felippekalil/MultiAVC/Documentação/Diagrama AVC ComarcIII.jpg

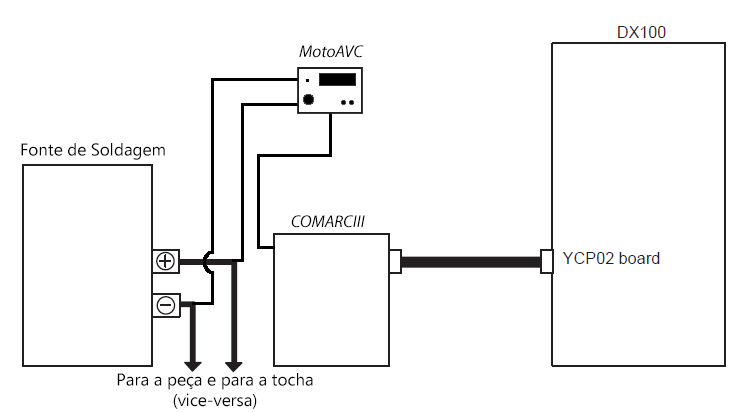
Documentação/Diagrama AVC ComarcIII.jpg
