felippekalil/MultiAVC/Documentação/Esquemático/LCD tela/TelaInicial.jpg

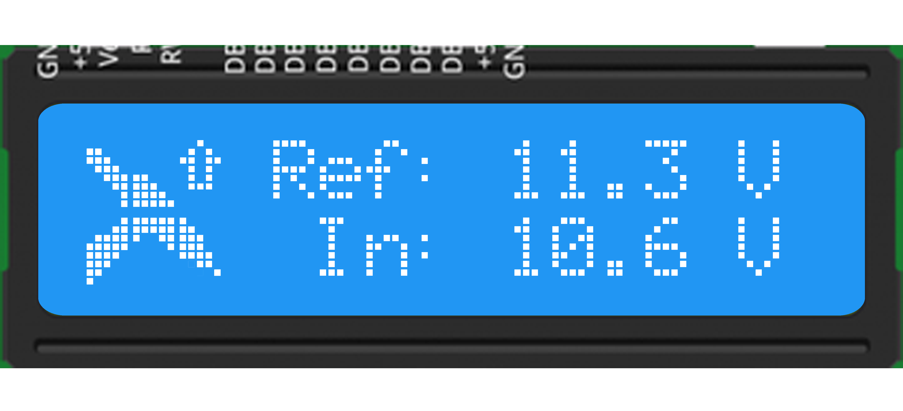
Documentação/Esquemático/LCD tela/TelaInicial.jpg
