felippekalil/MultiAVC/Documentação/IHM Exec.jpg

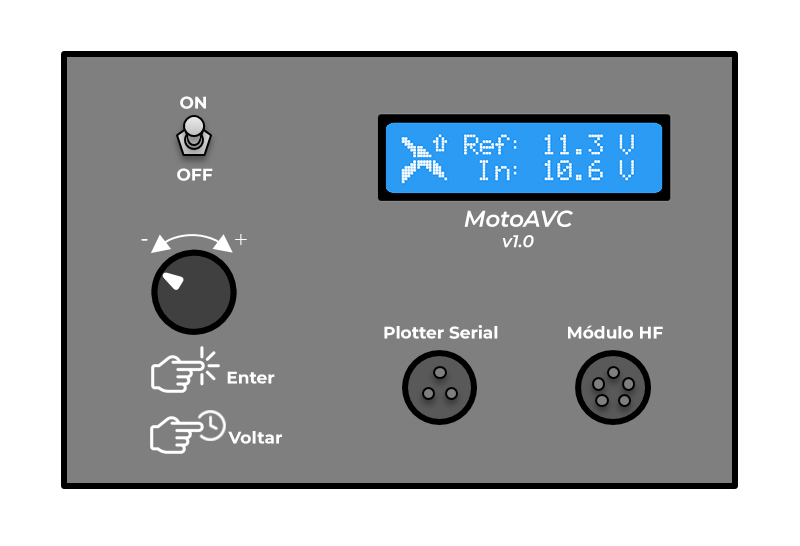
Documentação/IHM Exec.jpg
