felippekalil/MultiAVC/Documentação/Placa Filtro HF/Circuito Filtro HF.jpeg

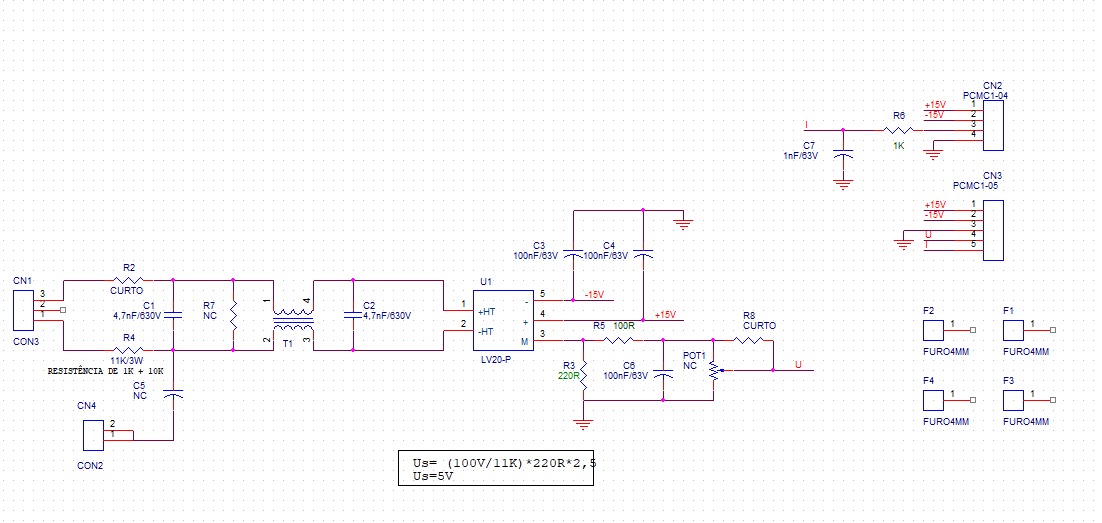
Documentação/Placa Filtro HF/Circuito Filtro HF.jpeg
