felippekalil/MultiAVC/PlotterAVC/Resources/simbolo_labsolda.png

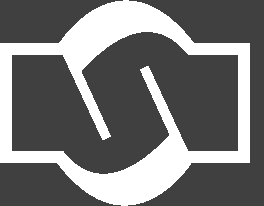
PlotterAVC/Resources/simbolo_labsolda.png
