felippekalil/MultiAVC/MotoAVC/Calibração Entrada.xlsx

ENTRADA PLACA | Tensão Display | Entrada ISO | ln | LNeper | Tensão Display | LNeper
0.1 | 0.08 | 0.08 | -2.525728644 | 2.525728644 | 0.08 | 2.525728644 | -1.003671372 | 0.07850838051 | -0.00149161949 | -1.003671 | 0.0785084485 | -0.0014915515
1.19 | 1.15 | 1.17 | 0.1570037488 | -0.1570037488 | 1.25 | -0.2231435513 | 0.9904970717 | 1.239136077 | 0.06913607729 | 0.990497 | 1.239135885 | 0.06913588489
1.92 | 1.85 | 2.62 | 0.9631743178 | -0.9631743178 | 2.67 | -0.9820784724 | 0.9983872139 | 2.654179794 | 0.03417979385 | 0.9991955079 | 2.654178633 | 0.03417863336
2.55 | 2.49 | 3.85 | 1.348073148 | -1.348073148 | 3.82 | -1.340250423 |  | 3.802362601 | -0.04763739914 |  | 3.802360432 | -0.04763956764
3.58 | 3.48 | 4.38 | 1.477048724 | -1.477048724 | 4.23 | -1.442201993 |  | 4.212045864 | -0.1679541359 |  | 4.212043302 | -0.1679566975
4.37 | 4.13 | 4.74 | 1.556037136 | -1.556037136 | 4.38 | -1.477048724 |  | 4.361967207 | -0.3780327935 |  | 4.361964497 | -0.3780355028
4.78 | 4.35 | 5 | 1.609437912 | -1.609437912 | 4.38 | -1.477048724 |  | 4.361967207 | -0.6380327935 |  | 4.361964497 | -0.6380355028
5 | 4.38
