felippekalil/MultiAVC/Documentação/Esquemático/MotoAVC Proteus/MotoAVC.PDF

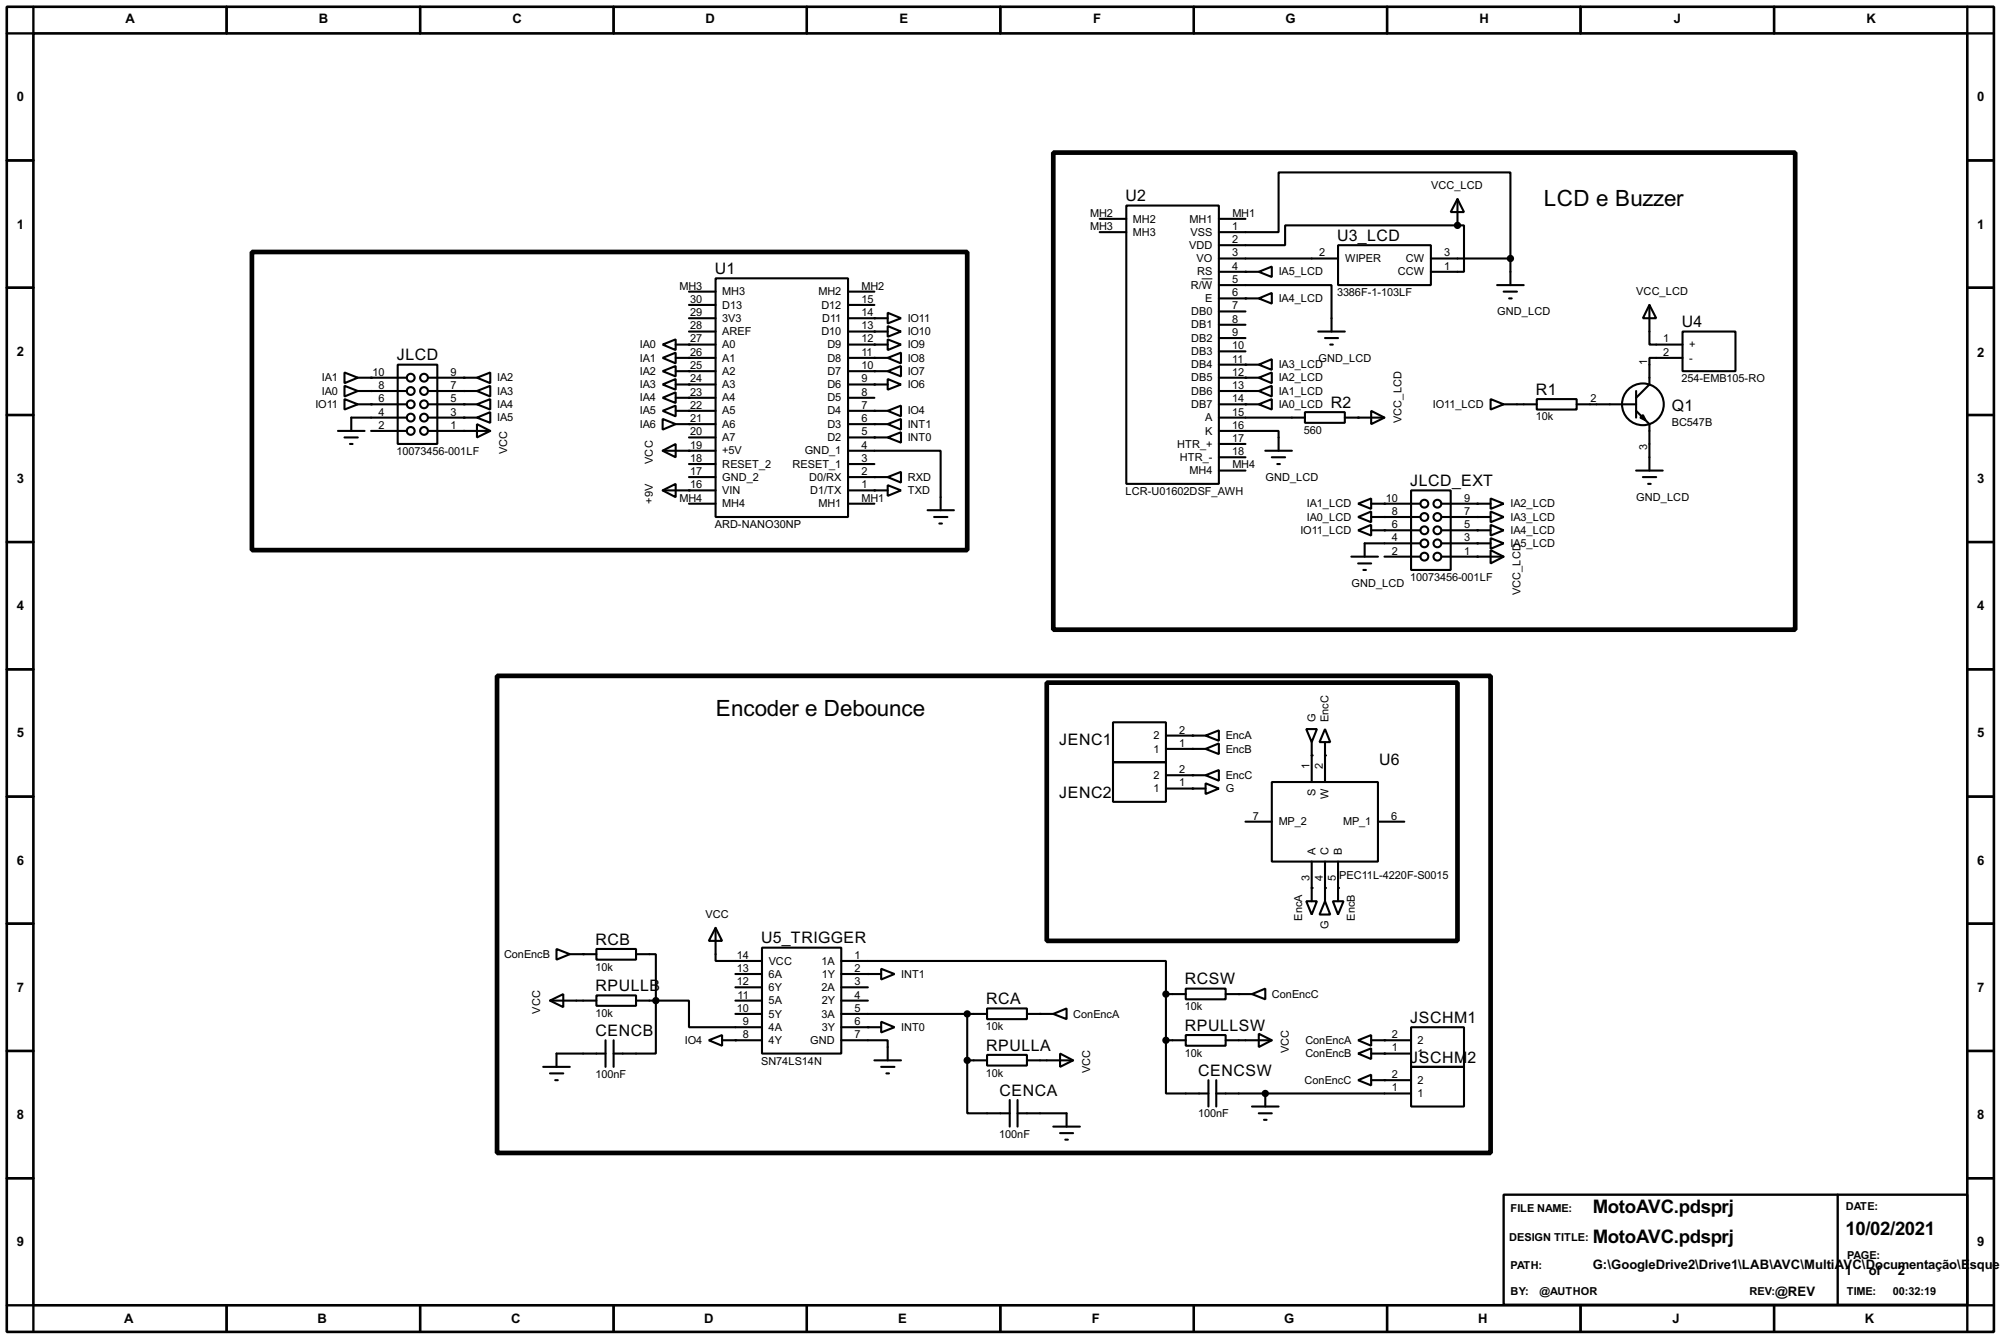
[picture p14: page 1]

2 VO
3 RS 4 R/W IA5_LCD 5 E | CCW | 1 WIPER

6 DB0 | IA4_LCD

10 | 10k
9 | 6 GND 7

FILE NAME:
DESIGN TITLE: MotoAVC.pdsprj

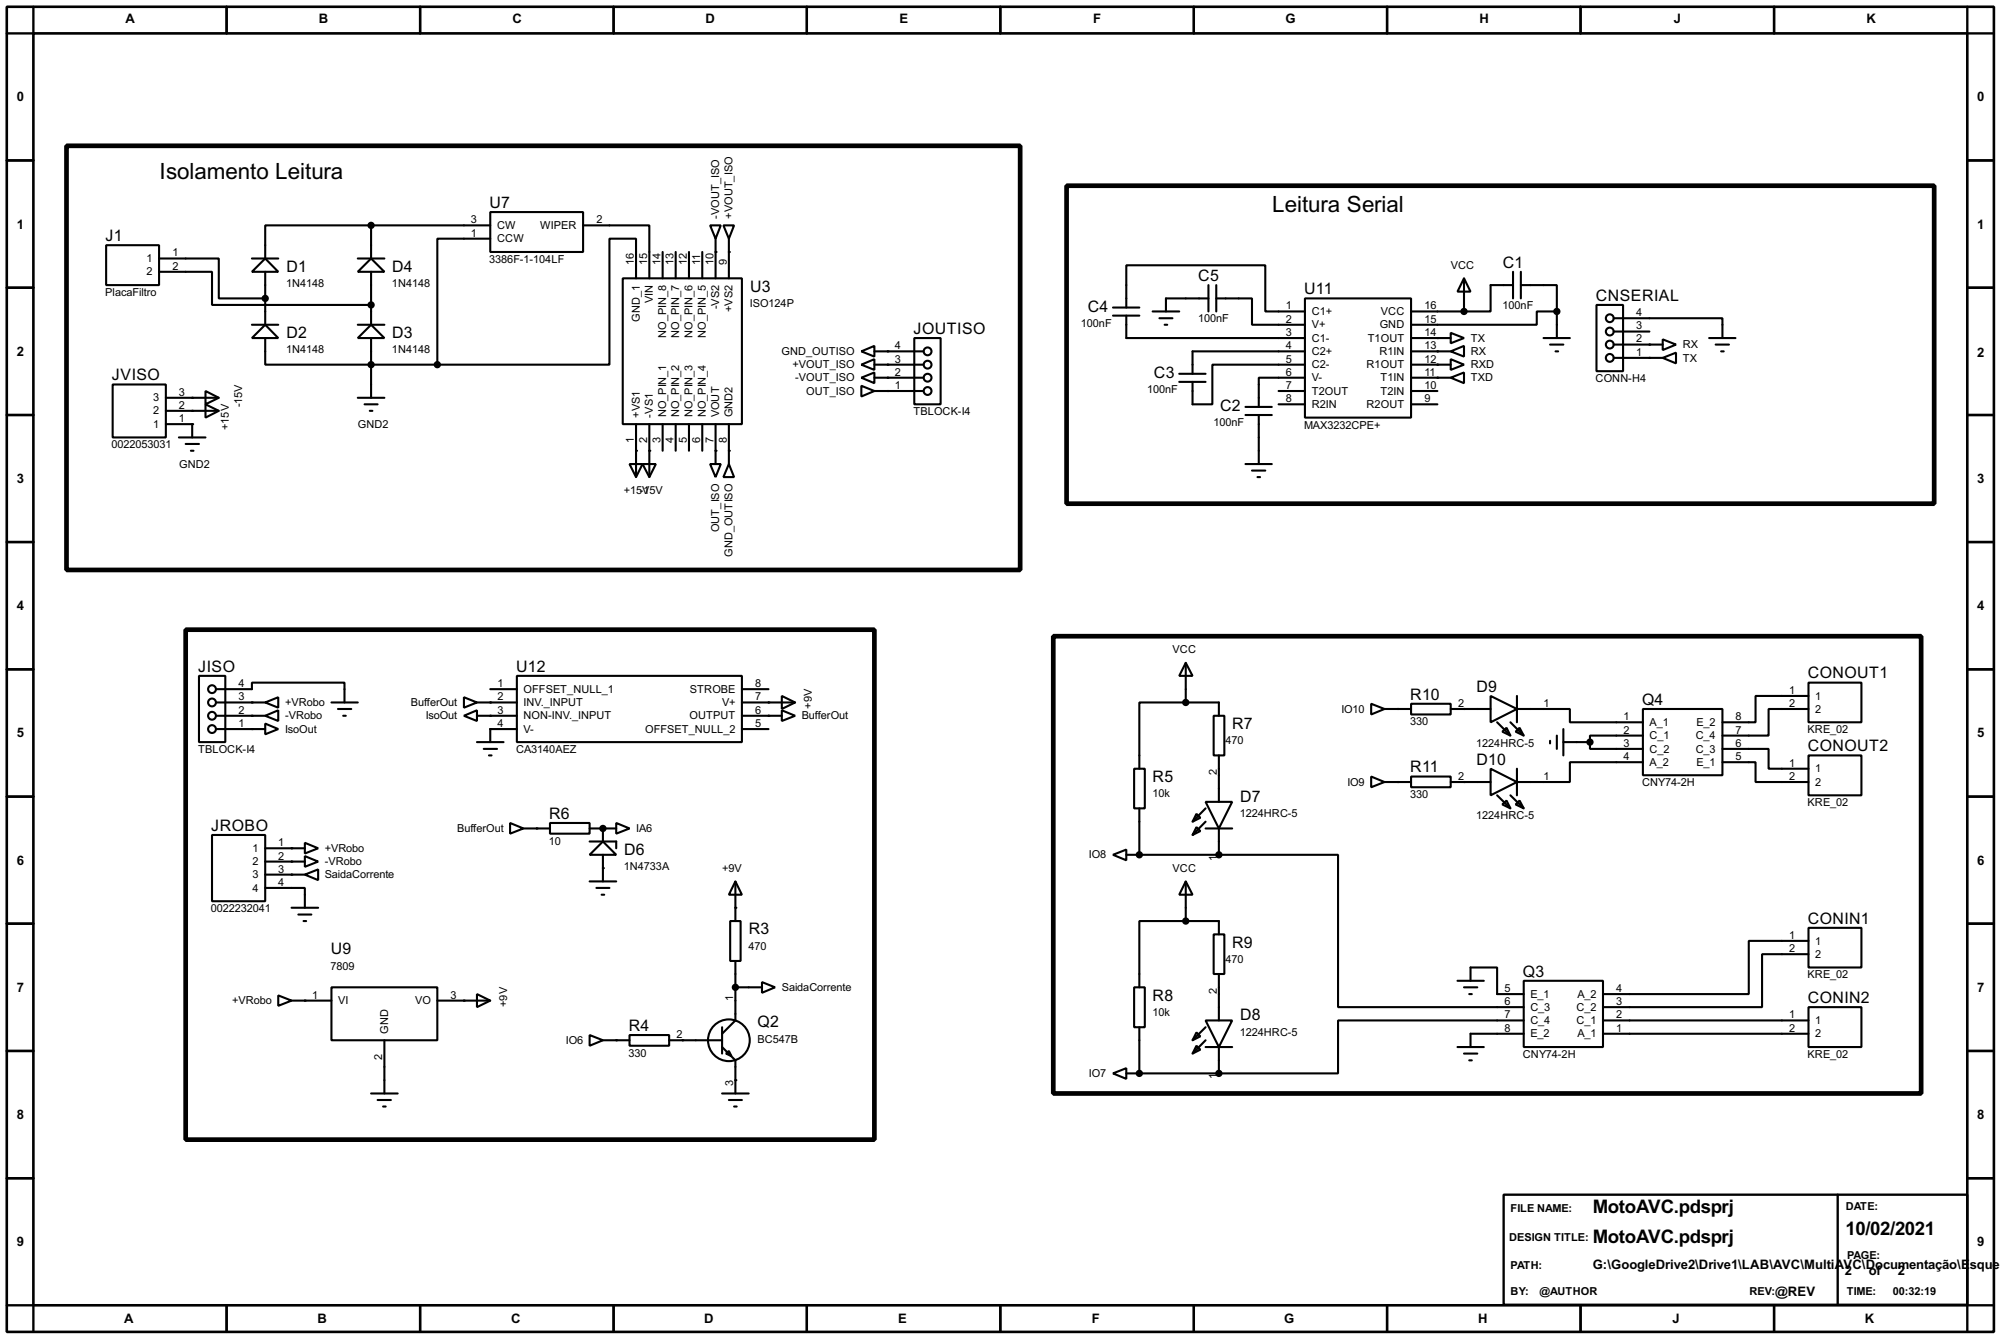
[picture p15: page 2]

FILE NAME:
DESIGN TITLE: MotoAVC.pdsprj
