felippekalil/MultiAVC/Documentação/Esquemático/MotoAVC_Circuito/MotoAVC - IHM.pdf

## Display e Buzzer

## Arduino Nano

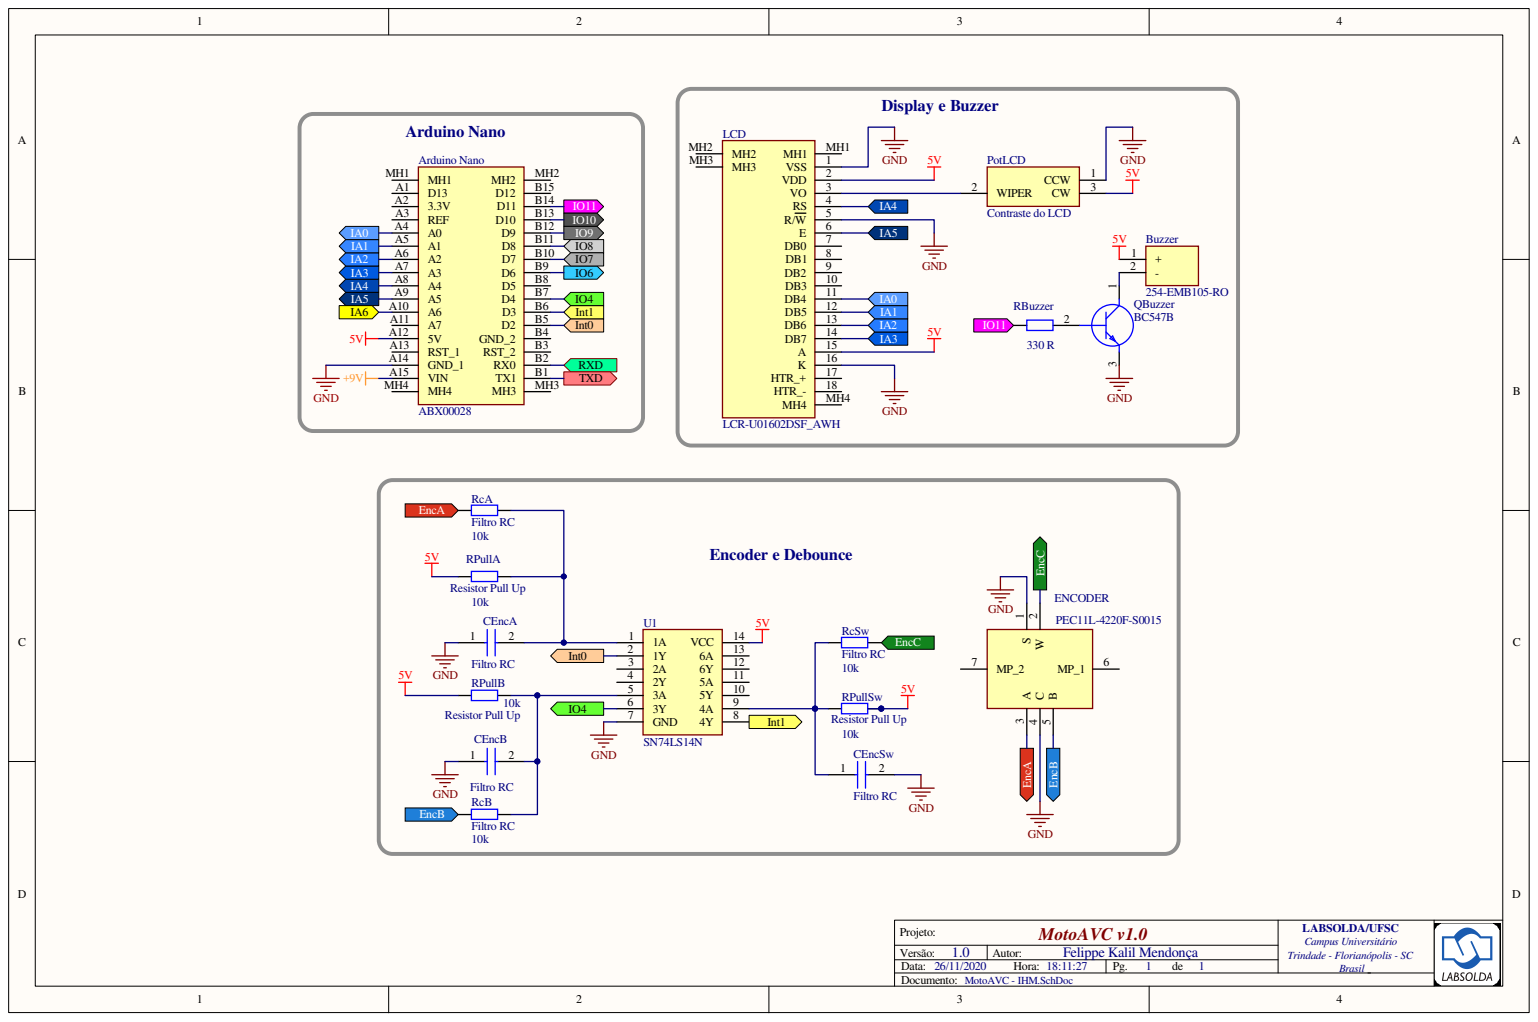
[picture p16: page 1]
