felippekalil/MultiAVC/Documentação/Esquemático/MotoAVC_Circuito/MotoAVC - Sinais.pdf

## Entrada Analógica

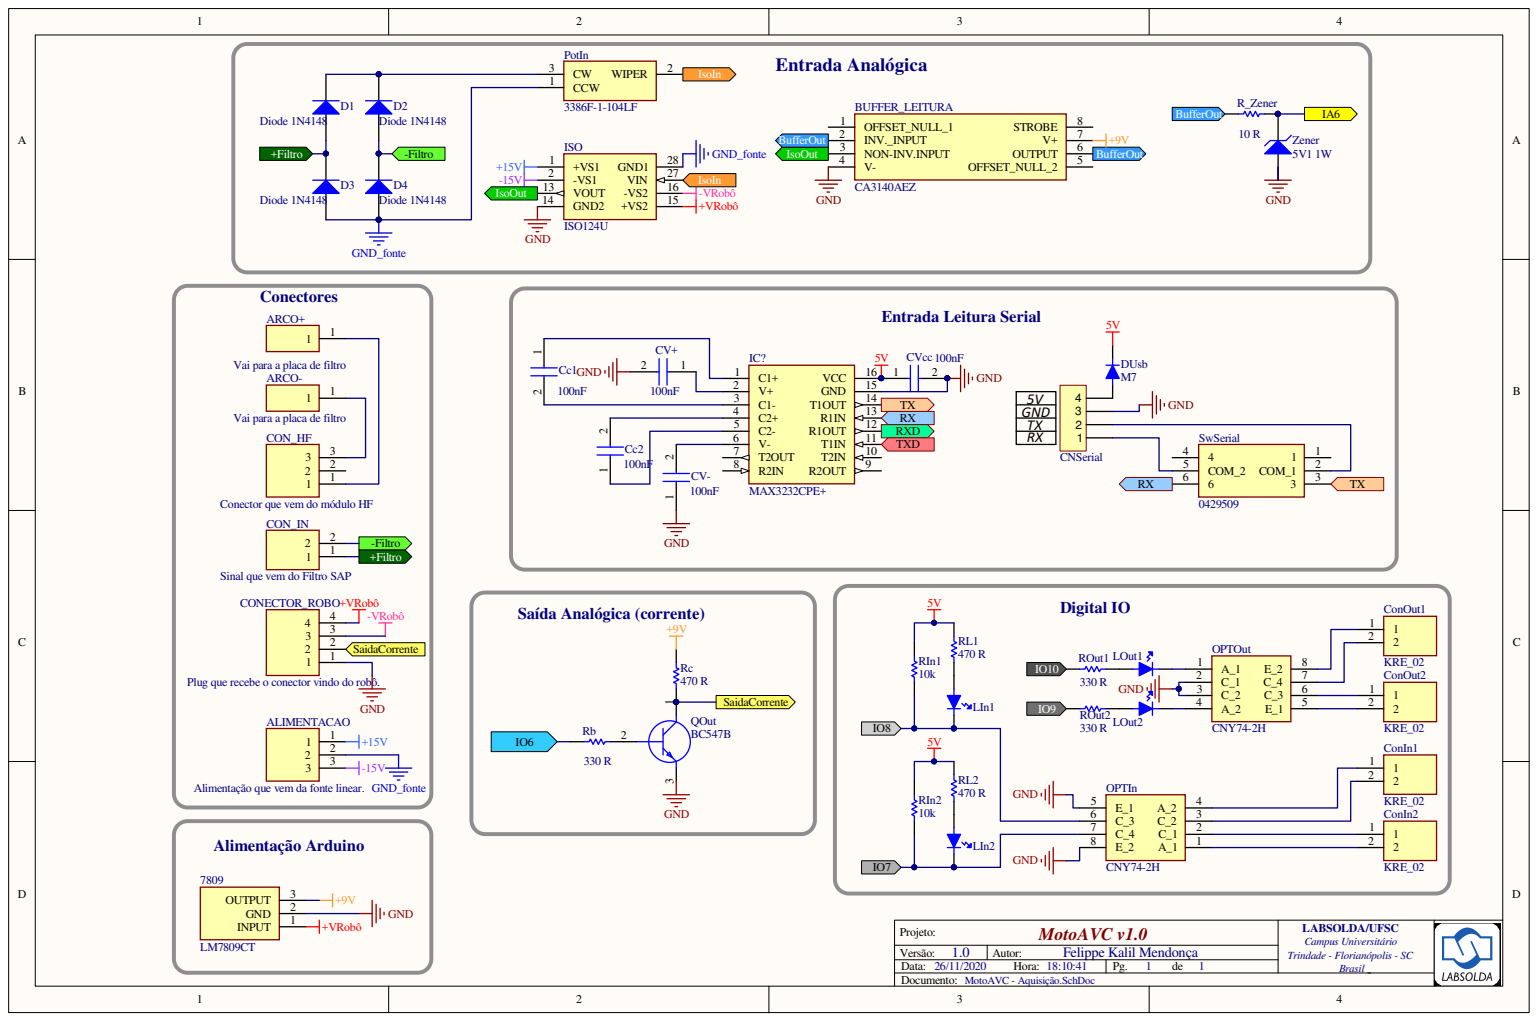
[picture p17: page 1]
1 Brasil; MotoAVC v1.0; Versão: Data: Documento:; Hora:; Autor:; Felippe Kalil Mendonça; Projeto:; CONECTOR_ROBO; GND; +VRobô -VRobô; +VS1 1 -VS1 2 VOUT 13; GND2 14; 16 VIN; 27 GND1; ISO; ISO124U; ALIMENTACAO; -VRobô +VRobô; GND_fonte; Diode 1N4148; D4 Diode 1N4148; D2 Diode 1N4148; CCW 1; WIPER; PotIn; -Filtro +Filtro; +Filtro; -Filtro; IsoIn; IsoOut; OFFSET_NULL_1 1 INV._INPUT 2 NON-INV.INPUT 3 V- 4; STROBE; OUTPUT; OFFSET_NULL_2; BUFFER_LEITURA; CA3140AEZ; BufferOut; INPUT; 1 GND; 2 OUTPUT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

Entrada Leitura Serial

Vai para a placa de filtro

Conector que vem do módulo HF

Sinal que vem do Filtro SAP

Saída Analógica (corrente)

Plug que recebe o conector vindo do robô.

Alimentação que vem da fonte linear. GND_fonte

LABSOLDA/UFSC
Campus Universitário
Trindade - Florianópolis - SC

MotoAVC - Aquisição.SchDoc
