felippekalil/MultiAVC/Documentação/Esquemático/MotoAVC_Circuito BKP/MotoAVC - Aquisição e IHM.pdf

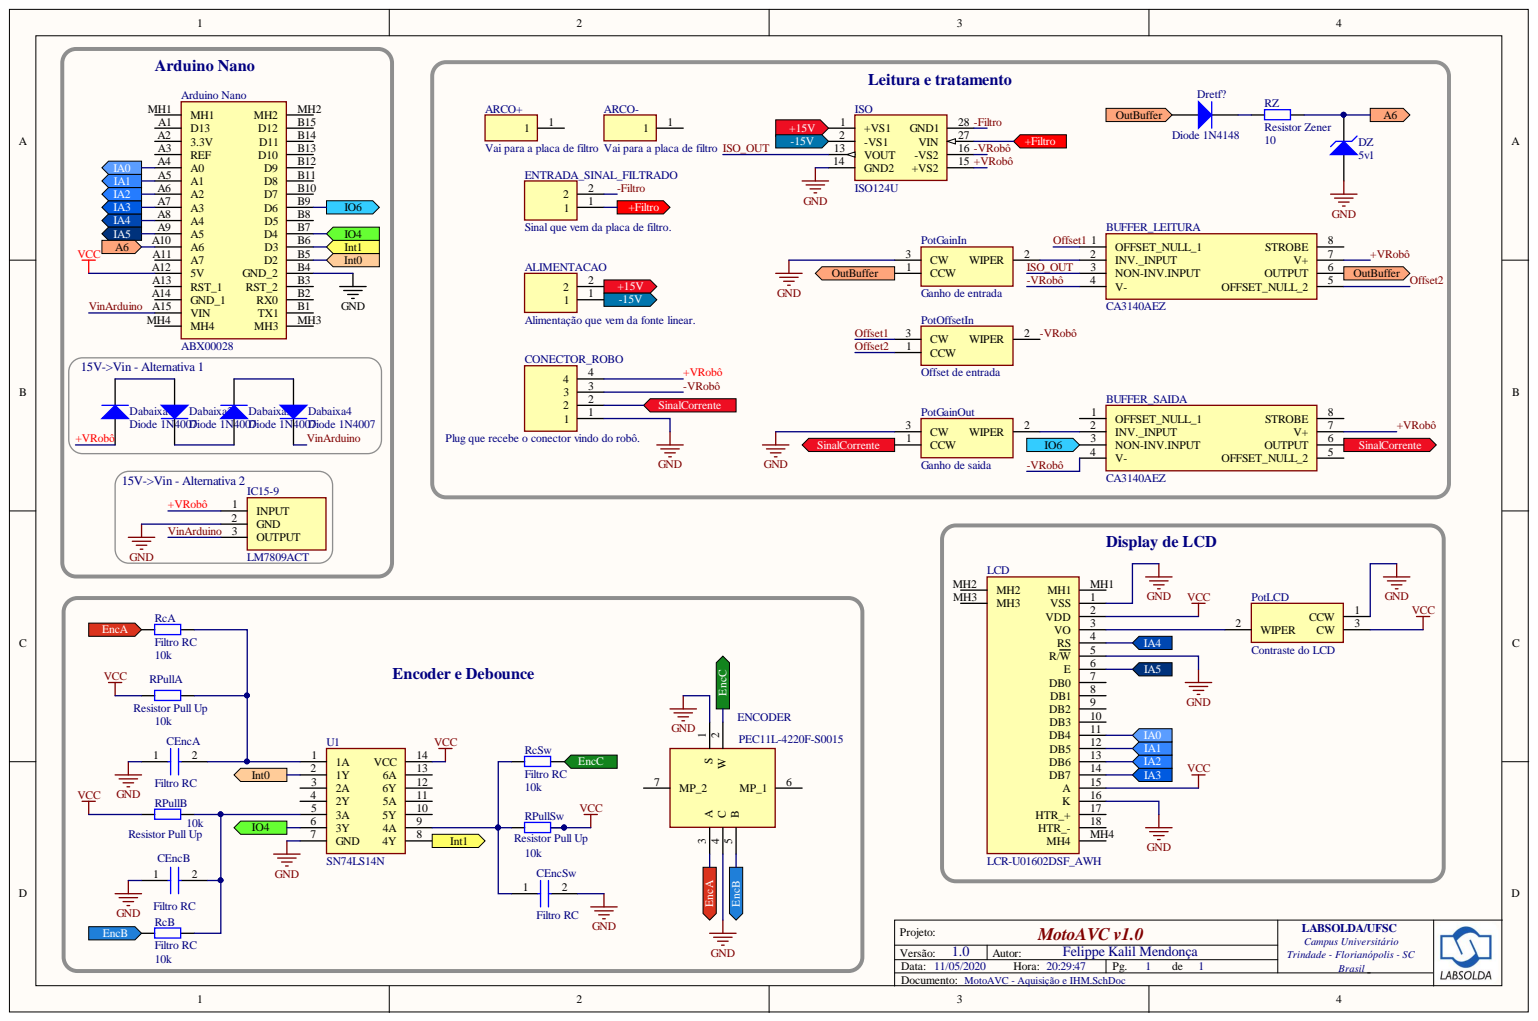
[picture p18: page 1]

Vai para a placa de filtro

Sinal que vem da placa de filtro.

Alimentação que vem da fonte linear.

Plug que recebe o conector vindo do robô.

Projeto: MotoAVC v1.0 | LABSOLDA/UFSC Campus Universitário Trindade - Florianópolis - SC Brasil

Versão: | Autor: Felippe Kalil Mendonça
Data: Hora: | Pg. 1 de 1

MotoAVC - Aquisição e IHM.SchDoc
