felippekalil/MultiAVC/(list of files, drawings)

Other design files:
Documentação/Esquemático/Arduino Nano 3/Arduino Nano 3.pdsprj
Documentação/Esquemático/MotoAVC Proteus/MotoAVC (1).pdsprj
Documentação/Esquemático/MotoAVC Proteus/MotoAVC.pdsprj
Documentação/Esquemático/MotoAVC_Circuito BKP/MotoAVC - Aquisição e IHM.SchDoc
Documentação/Esquemático/MotoAVC_Circuito BKP/MotoAVC - Aquisição.SchDoc
Documentação/Esquemático/MotoAVC_Circuito BKP/MotoAVC - IHM.SchDoc
Documentação/Esquemático/MotoAVC_Circuito BKP/PCB_MotoAVC.PrjPCB
Documentação/Esquemático/MotoAVC_Circuito/MotoAVC - Aquisição.SchDoc
Documentação/Esquemático/MotoAVC_Circuito/MotoAVC - IHM.SchDoc
Documentação/Esquemático/MotoAVC_Circuito/PCB_MotoAVC.PrjPCB
Documentação/Esquemático/MultiAVC.pdsprj
Documentação/Esquemático/Simulação/Arduino Nano 3/Arduino Nano 3.pdsprj
Documentação/Esquemático/TesteGanho.pdsprj
