felippekalil/MultiAVC/Base/Icones.cpp

#include "Icones.h"

// usar B100000 como identificador de final
const uint8_t Icones::FIM[] = {
	B100000,
	B00000,
	B00000,
	B00000,
	B00000,
	B00000,
	B00000,
	B00000
};
//
//const uint8_t Icones::logoTeste[][8] = { {
//	B00000,
//	B00000,
//	B00000,
//	B00000,
//	B00111,
//	B00100,
//	B00100,
//	B00100
//},{
//	B00000,
//	B00001,
//	B00111,
//	B01111,
//	B11110,
//	B01100,
//	B01100,
//	B00100
//},{
//	B00000,
//	B11000,
//	B11100,
//	B00010,
//	B00001,
//	B00000,
//	B01000,
//	B01100
//},{
//	B00000,
//	B00000,
//	B00000,
//	B00000,
//	B11100,
//	B00100,
//	B00100,
//	B00100
//},{
//	B00100,
//	B00100,
//	B00100,
//	B00111,
//	B00000,
//	B00000,
//	B00000,
//	B00000
//},{
//	B00110,
//	B00010,
//	B00000,
//	B10000,
//	B01000,
//	B00111,
//	B00011,
//	B00000
//},{
//	B00100,
//	B00110,
//	B00110,
//	B01111,
//	B11110,
//	B11100,
//	B10000,
//	B00000/*
//},{
//	B00100,
//	B00010,
//	B00010,
//	B00111,
//	B11110,
//	B11100,
//	B11000,
//	B00000//*/
//},{
//	B00100,
//	B00100,
//	B00100,
//	B11100,
//	B00000,
//	B00000,
//	B00000,
//	B00000
//}
//};

const uint8_t Icones::LOGO_LABSOLDA[][8] = { {
	B00000,
	B00000,
	B00000,
	B00000,
	B00111,
	B00100,
	B00100,
	B00100
},{
	B00000,
	B00001,
	B00111,
	B01111,
	B11110,
	B01100,
	B01100,
	B00100
},{
	B00000,
	B11000,
	B11100,
	B00010,
	B00001,
	B00000,
	B01000,
	B01100
},{
	B00000,
	B00000,
	B00000,
	B00000,
	B11100,
	B00100,
	B00100,
	B00100
},{
	B00100,
	B00100,
	B00100,
	B00111,
	B00000,
	B00000,
	B00000,
	B00000
},{
	B00110,
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
	B00000,
	B00000,
	B00000
},{
	B11100,
	B01000,
	B00000,
	B00000,
	B00000,
	B00000,
	B00000,
	B00000
},{
	B100000,
	B00000,
	B00000,
	B00000,
	B00000,
	B00000,
	B00000,
	B00000
}
};

const uint8_t Icones::CHAR_RAIO[8] = {
	B00111,
	B01110,
	B01100,
	B11111,
	B00110,
	B00100,
	B01000,
	B00000
};

const uint8_t Icones::CHAR_CURTO[8] = {
	B00010,
	B00100,
	B01100,
	B11111,
	B00110,
	B01110,
	B11100,
	B00000
};

const uint8_t Icones::CHAR_PULSE[8] = {
	B00000,
	B00000,
	B01110,
	B01010,
	B01010,
	B01010,
	B11011,
	B00000
};

const uint8_t Icones::CHAR_OK[8] = {
	B00000,
	B00000,
	B00001,
	B00010,
	B10100,
	B01000,
	B00000,	
	B00000 
};

const uint8_t Icones::CHAR_NONE[8] = {
	B00000,
	B10001,
	B01010,
	B00100,
	B01010,
	B10001,
	B00000,
	B00000
};

const uint8_t Icones::CHAR_UP[8] = {
	B00000,
	B00100,
	B01010,
	B11011,
	B01010,
	B01010,
	B01110,
	B00000
};

const uint8_t Icones::CHAR_DWN[8] = {
	B00000,
	B00000,
	B01110,
	B01010,
	B01010,
	B11011,
	B01010,
	B00100
};
