felippekalil/MultiAVC/Base/MenuEnum.h

// Menus.h

#ifndef _MENUS_h
#define _MENUS_h

#include "MenuBase.h"

class MenuEnum : public MenuBase
{
    String titulo;
    uint8_t nEnum;
    String* nomeModos;
    uint16_t enumerador = 0, enumeradorAnt = 0;
    MenuExtensoes::AdjGenerico<uint16_t> trocaEnum{};
    volatile byte select = 0;
    const uint16_t tAceso = 800, tApagado = 500, tLoop;
    MenuExtensoes::PiscaCiclo pisca;
    EnumMenus::Menus menuVoltar;

    void(*updateLogo)(Logo logo) = nullptr;
    Logo* logos = nullptr;

    uint8_t logoSize = 0;
    uint8_t offset = 0;

    void atualizaLogo() const;

public:
    MenuEnum(const String& titulo, EnumMenus::Menus* menuAtual, EnumMenus::Menus menuVoltar, uint8_t nEnum,
        String nomeEnums[], uint16_t tLoop);

    MenuEnum(const String& titulo, EnumMenus::Menus* menuAtual, EnumMenus::Menus menuVoltar, uint8_t nEnum,
        String nomeEnums[], Logo* logos, uint8_t logoSize, uint8_t offset, uint16_t tLoop);

    MenuEnum(const String& titulo, EnumMenus::Menus* menuAtual, EnumMenus::Menus menuVoltar, uint8_t nEnum,
        String nomeEnums[], byte(*logos[])[8], uint8_t logoSize, uint8_t offset,
        uint8_t offsetLogo, uint16_t tLoop);

    void onMenuIni(void (*logoUpdate)(Logo logos)) override;

    void onLoop() override;

    void onEncdrDec() override;

    void onEncdrInc() override;

    void onClick() override;

    void onVoltar() override;
};

#endif
