felippekalil/MultiAVC/(commit log)

2020-05-05 IHMv1 - Inicio ihm com encoder e IHMv2 guardada junto
2020-05-23 Retirada de comentários
2020-05-23 Add Esquemático
    [MotoAVC.pdsprj, TesteGanho.pdsprj]
2020-11-25 Pré Atualização Esquema
    [Arduino Nano 3.pdsprj, MotoAVC - Aquisição e IHM.SchDoc, MotoAVC - Aquisição.SchDoc, MotoAVC - IHM.SchDoc, MultiAVC.pdsprj, PCB_MotoAVC.PrjPCB, TesteGanho.pdsprj]
2020-11-26 Update Hardware MotoAVC Solo
    [MotoAVC - Aquisição e IHM.SchDoc, MotoAVC - Aquisição.SchDoc, MotoAVC - IHM.SchDoc, PCB_MotoAVC.PrjPCB, TesteGanho.pdsprj]
2020-12-21 P´re Bug ControleAVC Fix
    [ControleAVC.cpp, ControleAVC.h, IHMv2.cpp]
2021-03-19 Bug Ajuste ZM e Mult
    [Calibração Entrada.xlsx, MotoAVC (1).pdsprj, MotoAVC - Aquisição.SchDoc, MotoAVC - IHM.SchDoc, MotoAVC.pdsprj, PCB_MotoAVC.PrjPCB, TesteGanho.pdsprj]
2021-05-19 Pré progmem logo
    [Arduino Nano 3.pdsprj, MotoAVC (1).pdsprj, MotoAVC - Aquisição e IHM.SchDoc, MotoAVC - Aquisição.SchDoc, MotoAVC - IHM.SchDoc, MotoAVC.pdsprj, MultiAVC.pdsprj, PCB_MotoAVC.PrjPCB]
2021-05-25 Release 1 com buzzer
    [IHMv2.cpp]
2023-05-27 tDelay rodando 2
    [Calibração Entrada.xlsx]
2025-04-26 Getting back
    [Arduino Nano 3.pdsprj]
